Wontfallo/DIY-Vacuum-Controller/cad/previews/exploded.png

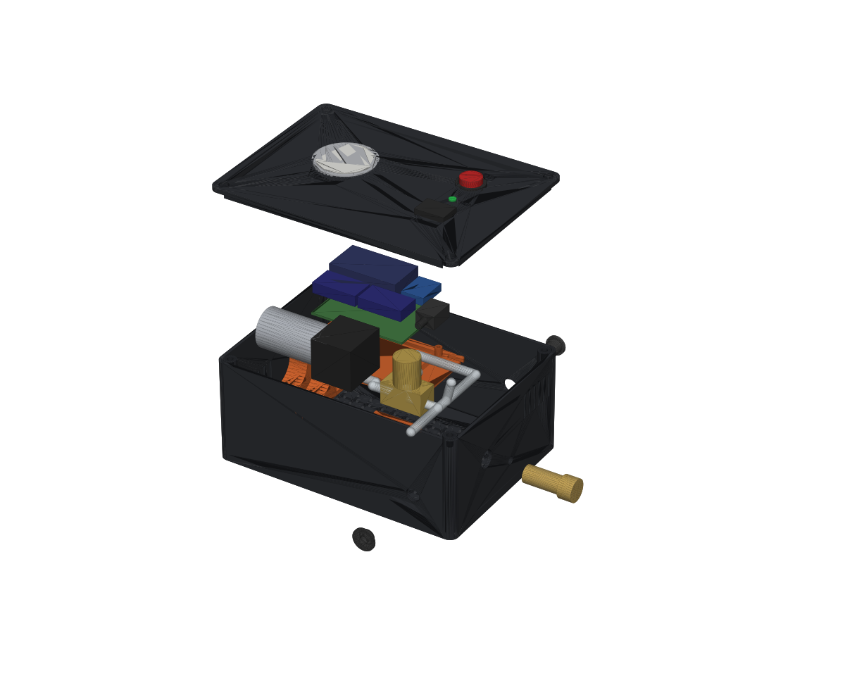
cad/previews/exploded.png
