Wontfallo/DIY-Vacuum-Controller/cad/previews/printed_parts.png

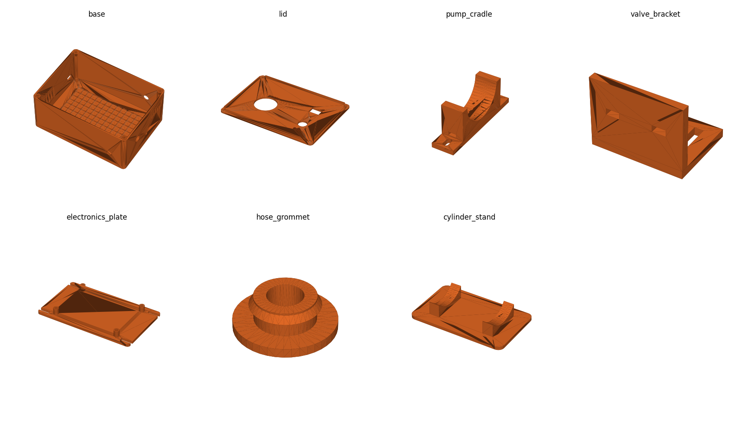
cad/previews/printed_parts.png
