Wontfallo/DIY-Vacuum-Controller/cad/step/assembly.step

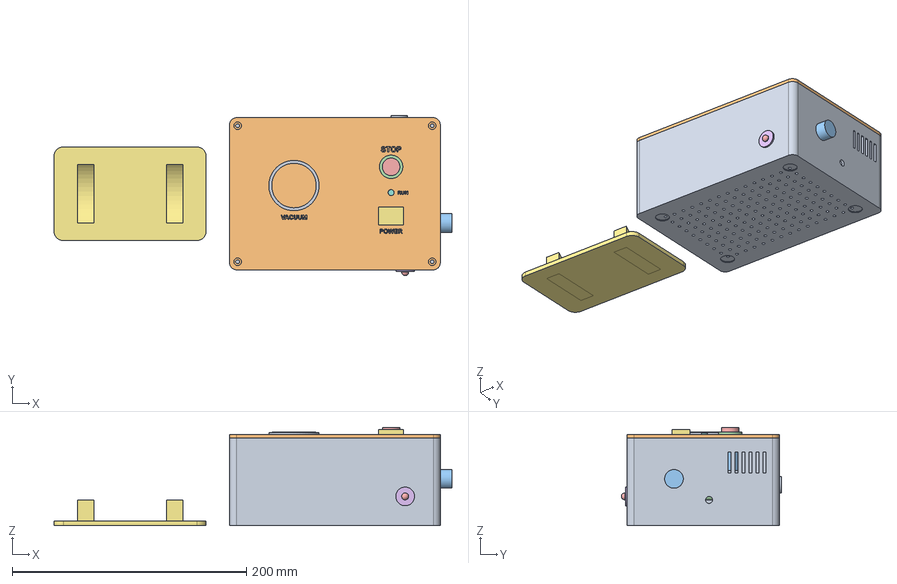
[picture p3: CAD file, 2026-10-19]
cad/step/assembly.step
340.0 x 137.0 x 84.0 mm
base
lid
pump_cradle_a
pump_cradle_b
valve_bracket
electronics_plate
hose_grommet
cylinder_stand
pump_motor
pump_head
vent_valve
perfboard
esp32
mosfet_pump
mosfet_valve
buck_5v
pressure_sensor
gauge
gauge_face
stop_button
stop_cap
rocker_switch
status_led
dc_jack
relief_valve
tubing
