Wontfallo/DIY-Vacuum-Controller/cad/blender/parts/mosfet_pump.stl

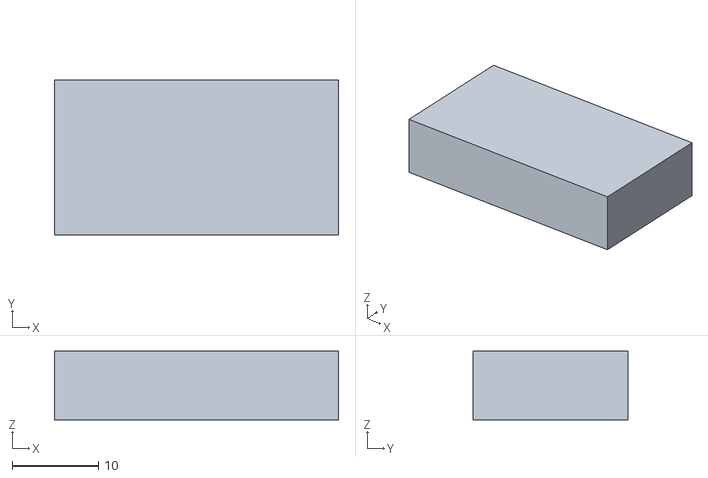
[picture p4: CAD file, 2026-10-19]
cad/blender/parts/mosfet_pump.stl
33.0 x 18.0 x 8.00
