Wontfallo/DIY-Vacuum-Controller/cad/step/valve_bracket.step

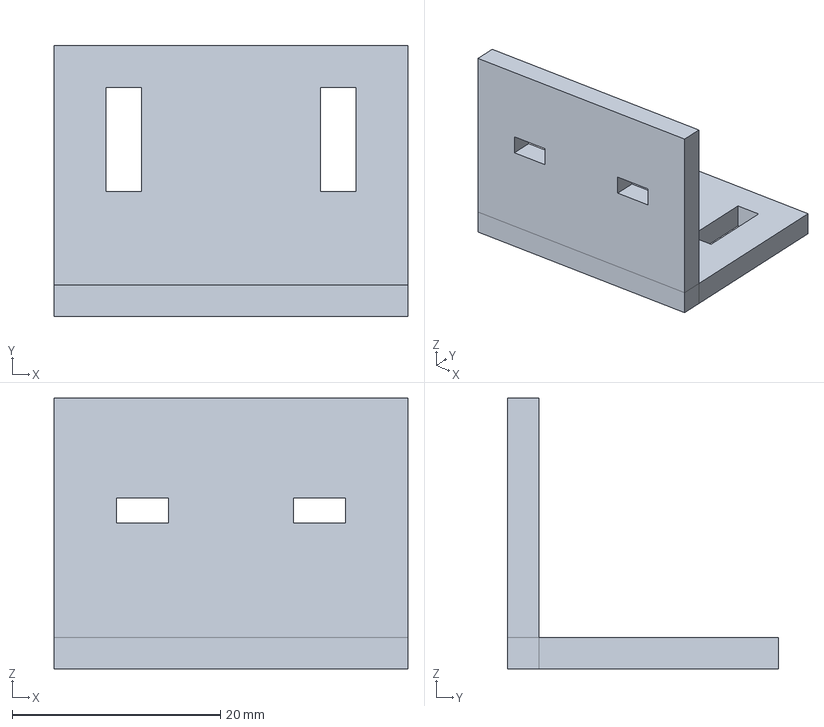
[picture p5: CAD file, 2026-10-19]
cad/step/valve_bracket.step
34.0 x 26.0 x 26.0 mm
