Wontfallo/DIY-Vacuum-Controller/cad/blender/parts/gauge.stl

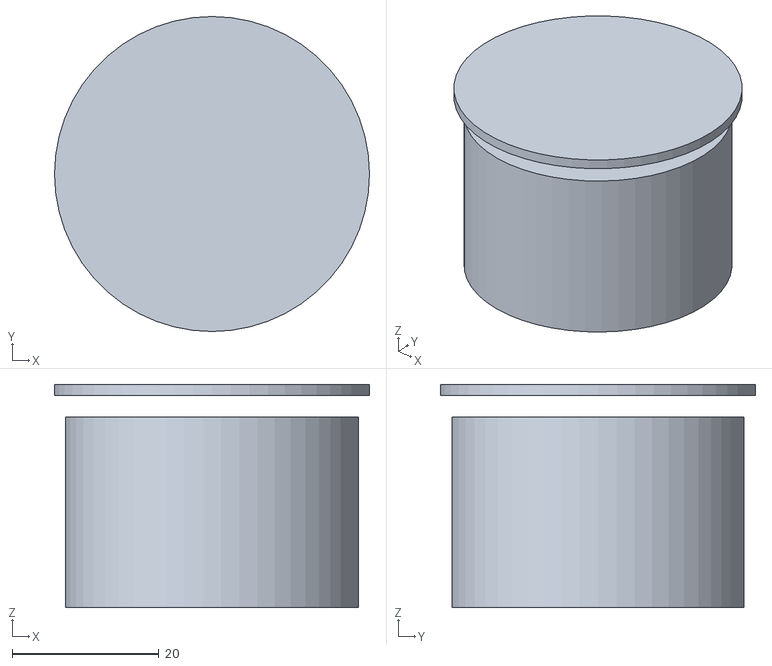
[picture p6: CAD file, 2026-10-19]
cad/blender/parts/gauge.stl
43.0 x 43.0 x 30.5
