Wontfallo/DIY-Vacuum-Controller/cad/step/base.step

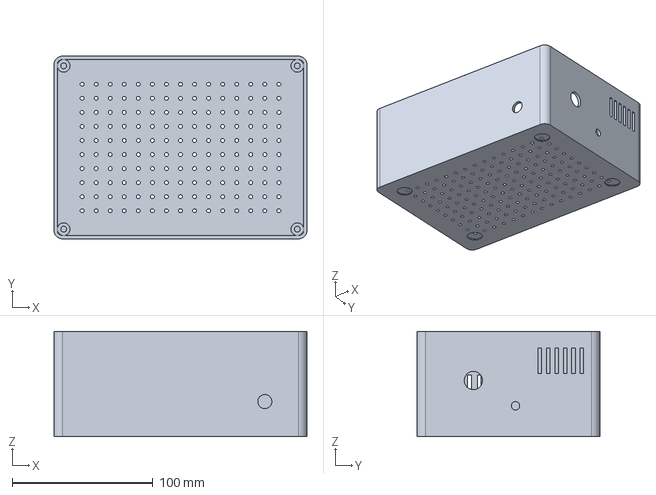
[picture p7: CAD file, 2026-10-19]
cad/step/base.step
180.0 x 130.0 x 75.0 mm
