Wontfallo/DIY-Vacuum-Controller/cad/blender/parts/stop_button.stl

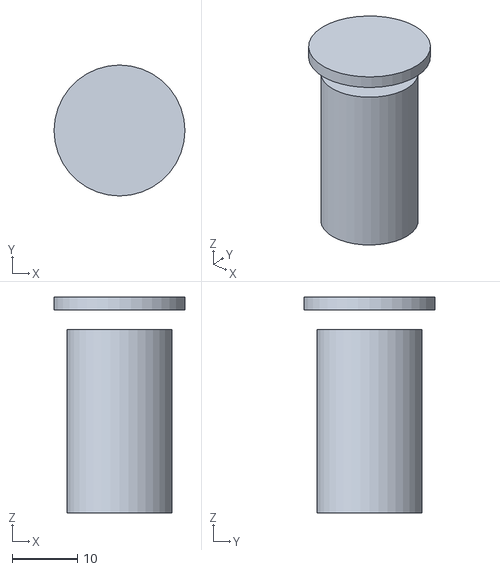
[picture p8: CAD file, 2026-10-19]
cad/blender/parts/stop_button.stl
20.0 x 20.0 x 33.0
