Wontfallo/DIY-Vacuum-Controller/cad/step/hose_grommet.step

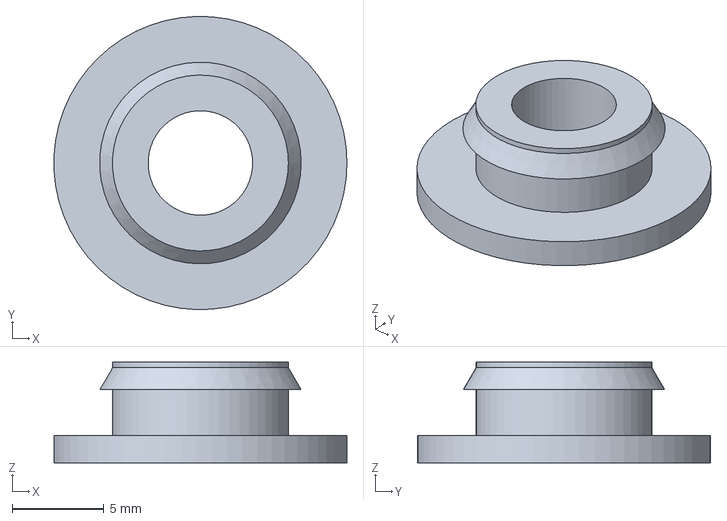
[picture p9: CAD file, 2026-10-19]
cad/step/hose_grommet.step
16.0 x 16.0 x 5.50 mm
