Wontfallo/DIY-Vacuum-Controller/cad/blender/parts/dc_jack.stl

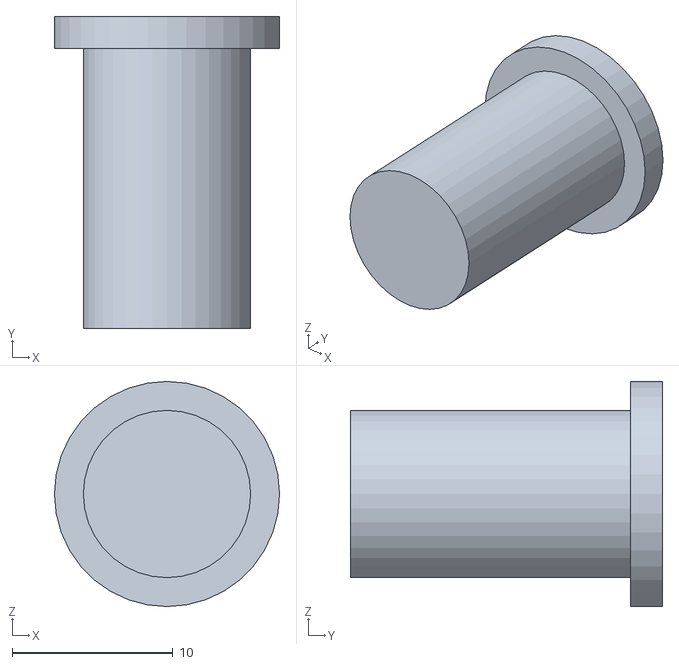
[picture p10: CAD file, 2026-10-19]
cad/blender/parts/dc_jack.stl
14.0 x 19.4 x 14.0
