Wontfallo/DIY-Vacuum-Controller/cad/step/cylinder_stand.step

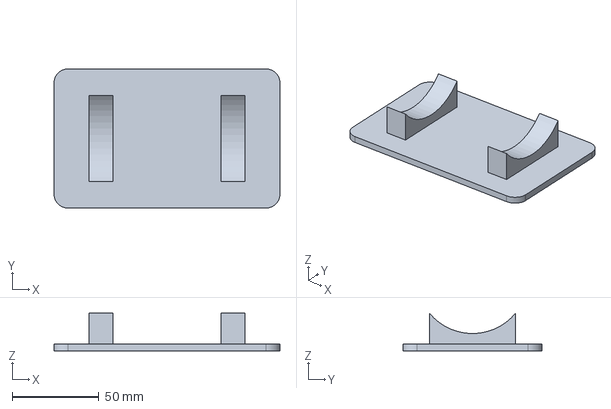
[picture p11: CAD file, 2026-10-19]
cad/step/cylinder_stand.step
130.0 x 80.0 x 21.8 mm
