Wontfallo/DIY-Vacuum-Controller/cad/blender/parts/electronics_plate.stl

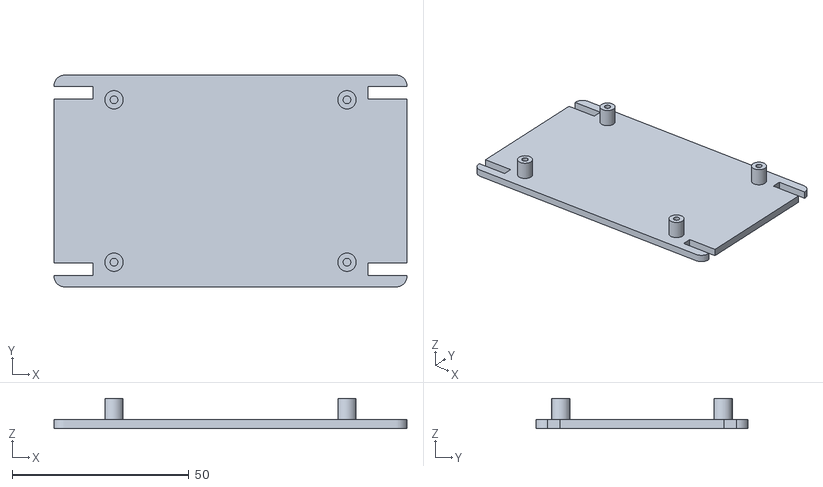
[picture p12: CAD file, 2026-10-19]
cad/blender/parts/electronics_plate.stl
100.0 x 60.0 x 8.50
