Wontfallo/DIY-Vacuum-Controller/cad/blender/parts/perfboard.stl

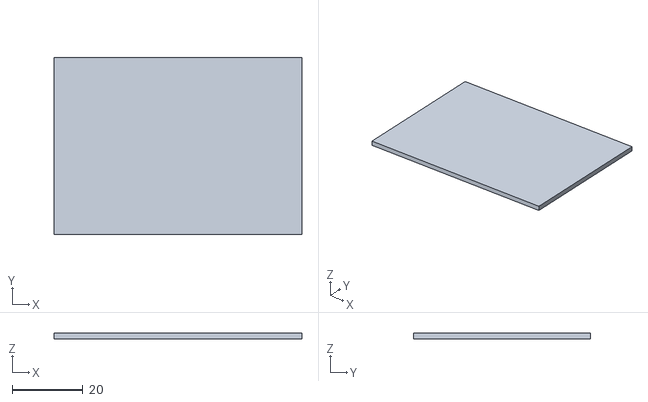
[picture p13: CAD file, 2026-10-19]
cad/blender/parts/perfboard.stl
70.0 x 50.0 x 1.60
