Wontfallo/DIY-Vacuum-Controller/cad/step/lid.step

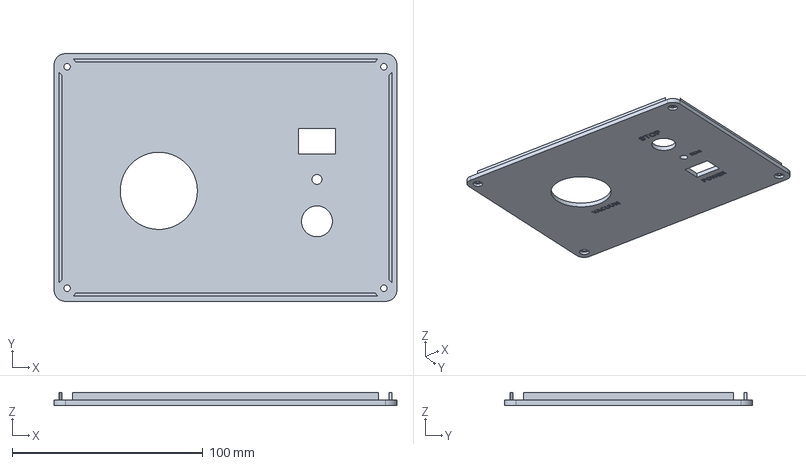
[picture p14: CAD file, 2026-10-19]
cad/step/lid.step
180.0 x 130.0 x 7.00 mm
