Wontfallo/DIY-Vacuum-Controller/cad/step/pump_cradle.step

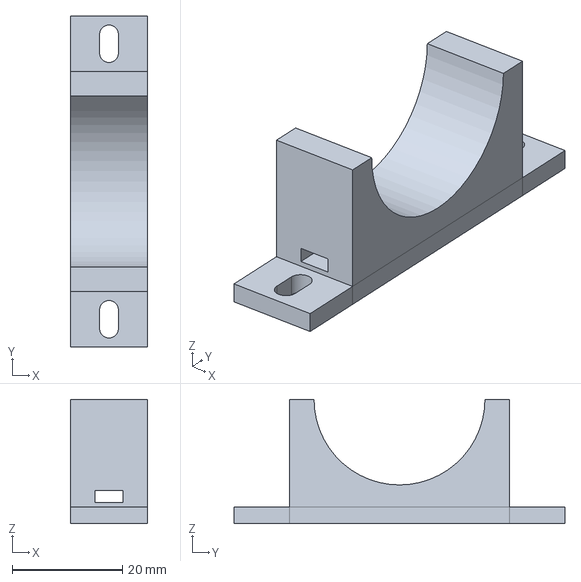
[picture p15: CAD file, 2026-10-19]
cad/step/pump_cradle.step
14.0 x 60.0 x 22.5 mm
