Wontfallo/DIY-Vacuum-Controller/cad/blender/parts/pump_head.stl

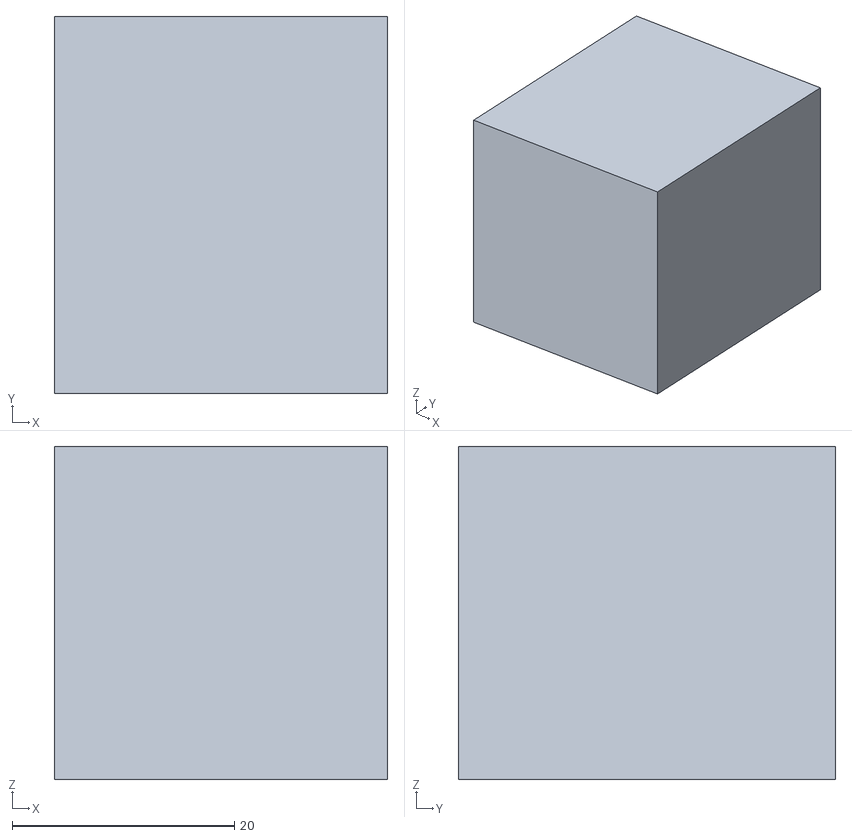
[picture p16: CAD file, 2026-10-19]
cad/blender/parts/pump_head.stl
30.0 x 34.0 x 30.0
