Wontfallo/DIY-Vacuum-Controller/cad/blender/parts/rocker_switch.stl

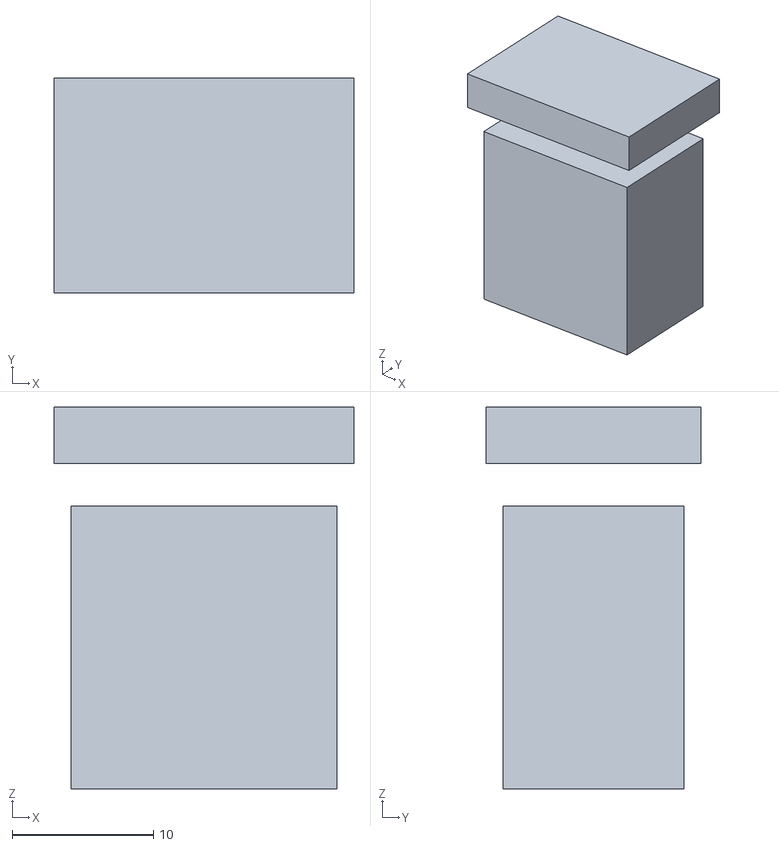
[picture p17: CAD file, 2026-10-19]
cad/blender/parts/rocker_switch.stl
21.2 x 15.2 x 27.0
