Wontfallo/DIY-Vacuum-Controller/cad/blender/parts/esp32.stl

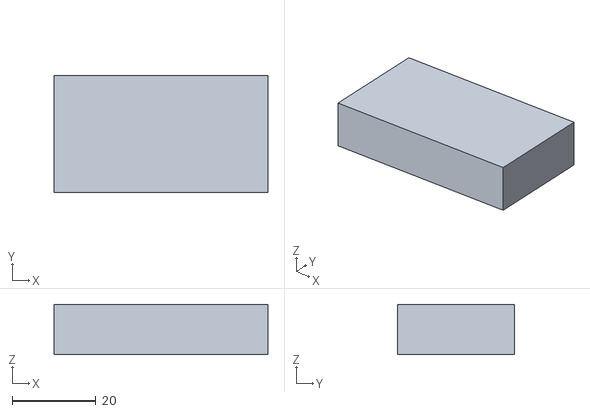
[picture p18: CAD file, 2026-10-19]
cad/blender/parts/esp32.stl
51.0 x 28.0 x 12.0
