Wontfallo/DIY-Vacuum-Controller/cad/blender/parts/vent_valve.stl

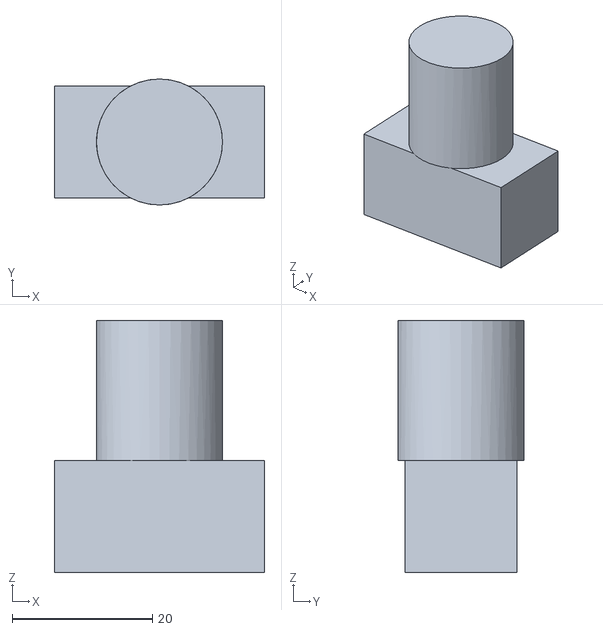
[picture p19: CAD file, 2026-10-19]
cad/blender/parts/vent_valve.stl
30.0 x 18.0 x 36.0
