Wontfallo/DIY-Vacuum-Controller/cad/blender/parts/gauge_face.stl

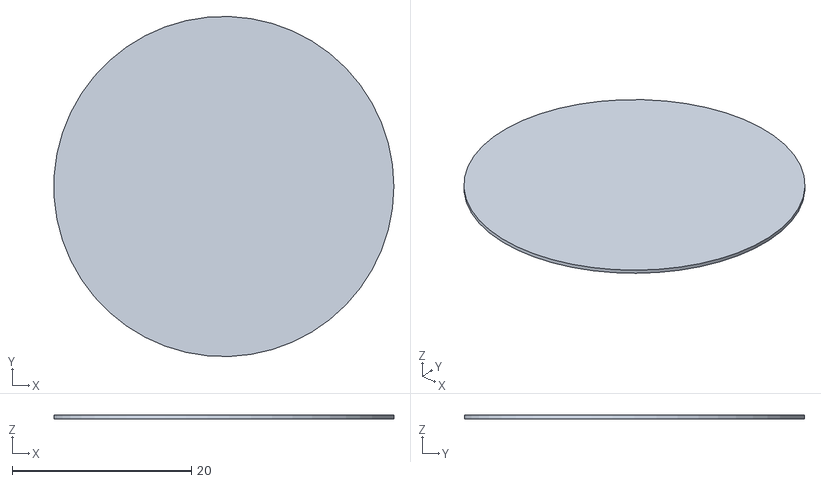
[picture p20: CAD file, 2026-10-19]
cad/blender/parts/gauge_face.stl
38.0 x 38.0 x 0.4
