Wontfallo/DIY-Vacuum-Controller/cad/blender/parts/tubing.stl

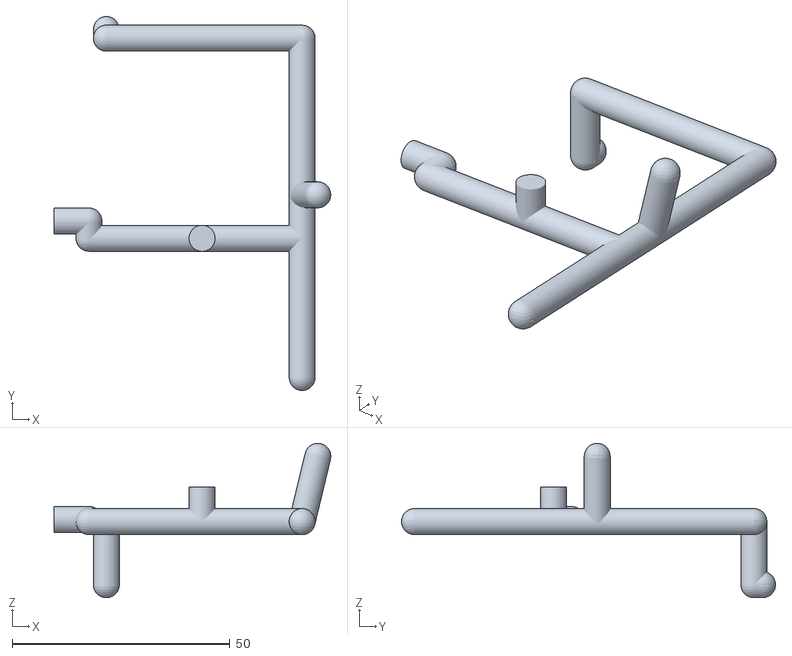
[picture p21: CAD file, 2026-10-19]
cad/blender/parts/tubing.stl
63.6 x 86.0 x 35.5
