Wontfallo/DIY-Vacuum-Controller/cad/blender/parts/pump_motor.stl

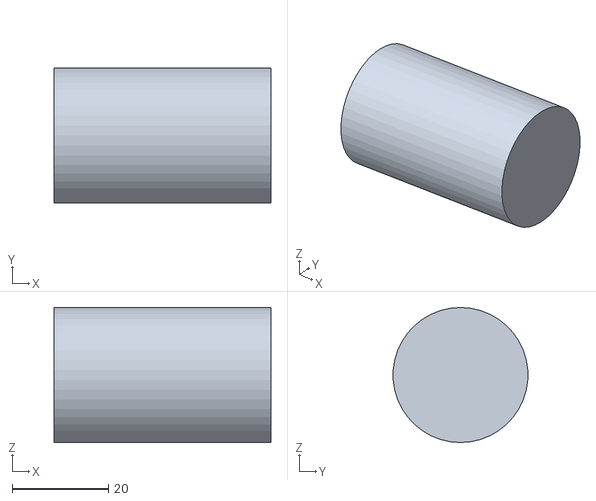
[picture p22: CAD file, 2026-10-19]
cad/blender/parts/pump_motor.stl
45.0 x 27.9 x 28.0
