Wontfallo/DIY-Vacuum-Controller/cad/blender/parts/hose_grommet.stl

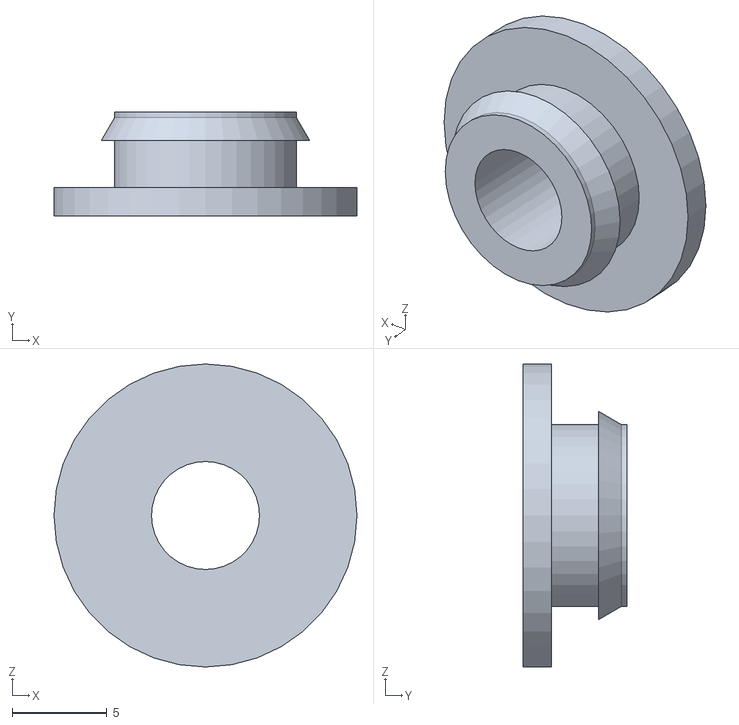
[picture p23: CAD file, 2026-10-19]
cad/blender/parts/hose_grommet.stl
16.0 x 5.50 x 16.0
