Wontfallo/DIY-Vacuum-Controller/cad/blender/parts/stop_cap.stl

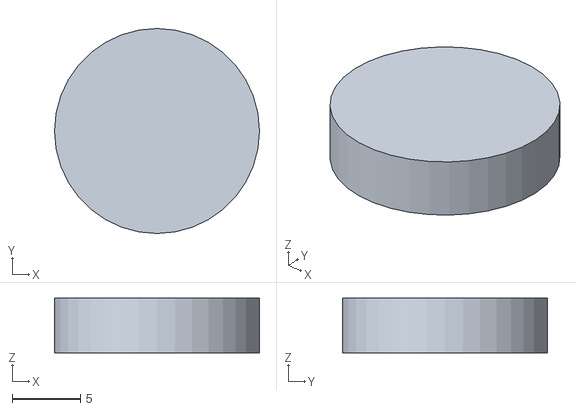
[picture p24: CAD file, 2026-10-19]
cad/blender/parts/stop_cap.stl
15.0 x 15.0 x 4.00
