Wontfallo/DIY-Vacuum-Controller/cad/blender/parts/buck_5v.stl

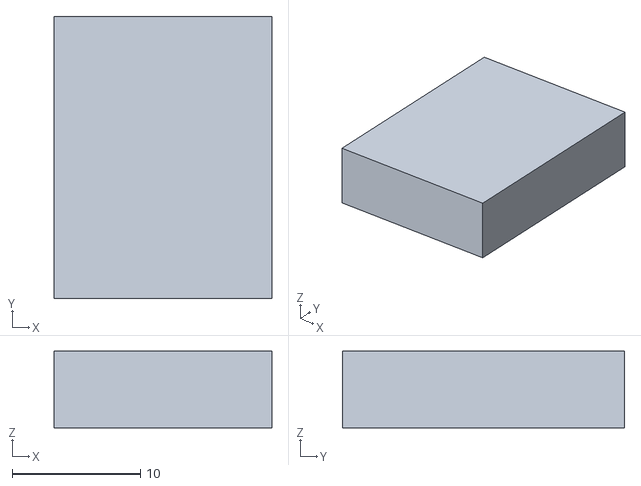
[picture p25: CAD file, 2026-10-19]
cad/blender/parts/buck_5v.stl
17.0 x 22.0 x 6.00
