Wontfallo/DIY-Vacuum-Controller/cad/blender/parts/status_led.stl

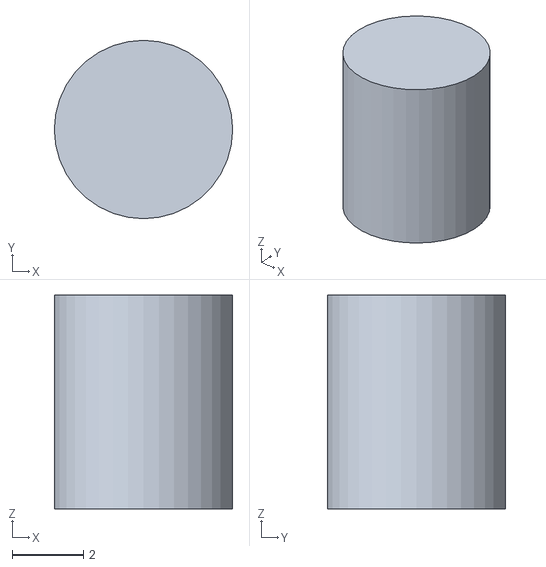
[picture p26: CAD file, 2026-10-19]
cad/blender/parts/status_led.stl
5.00 x 5.00 x 6.00
