Wontfallo/DIY-Vacuum-Controller/cad/blender/parts/pressure_sensor.stl

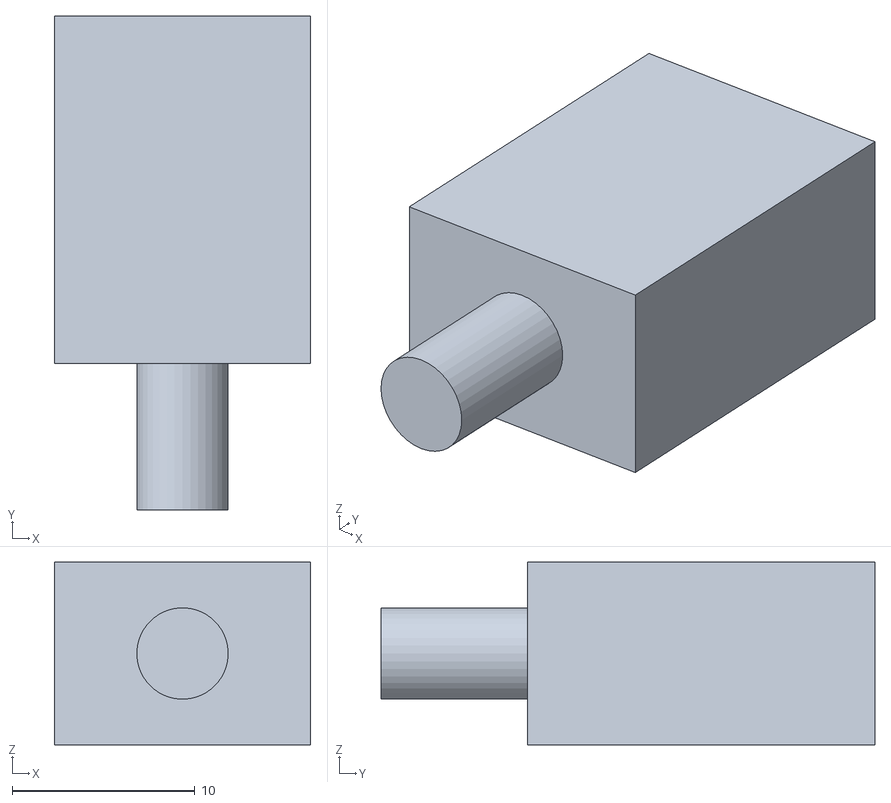
[picture p27: CAD file, 2026-10-19]
cad/blender/parts/pressure_sensor.stl
14.0 x 27.0 x 10.0
