Wontfallo/DIY-Vacuum-Controller/cad/blender/parts/relief_valve.stl

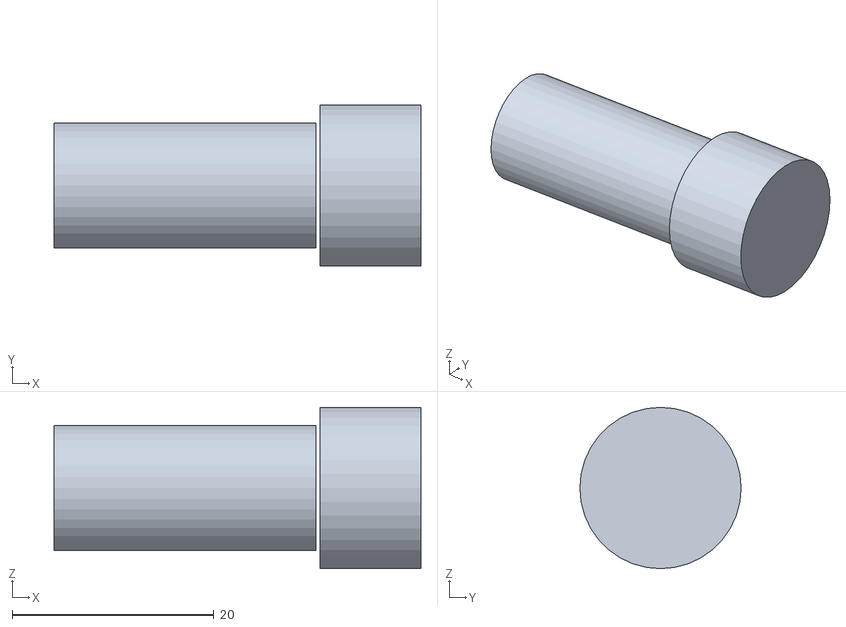
[picture p28: CAD file, 2026-10-19]
cad/blender/parts/relief_valve.stl
36.4 x 16.0 x 16.0
