Wontfallo/DIY-Vacuum-Controller/(list of files, cad)

Other CAD files:
cad/VacController.FCStd
cad/blender/parts/lid.stl
cad/step/electronics_plate.step
cad/blender/parts/valve_bracket.stl
cad/blender/parts/base.stl
cad/blender/parts/pump_cradle_b.stl
cad/blender/parts/mosfet_valve.stl
cad/blender/parts/pump_cradle_a.stl
cad/blender/parts/cylinder_stand.stl
cad/blender/vaccontroller_demo.blend
cad/stl/base.stl
cad/stl/cylinder_stand.stl
cad/stl/electronics_plate.stl
cad/stl/hose_grommet.stl
cad/stl/lid.stl
cad/stl/pump_cradle.stl
cad/stl/valve_bracket.stl
