Wontfallo/DIY-Vacuum-Controller/cad/previews/assembly.png

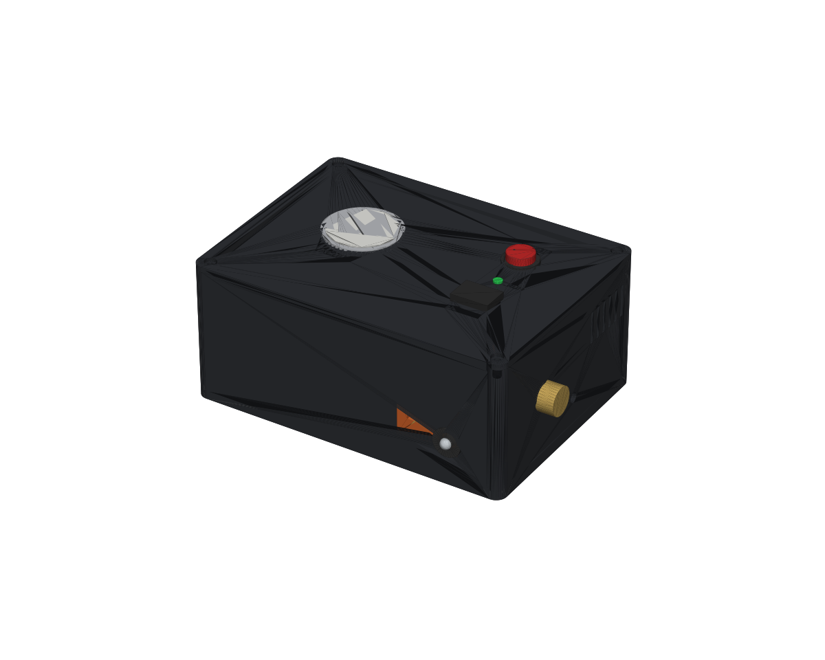
cad/previews/assembly.png
